kamocat/ErgoDox/ErgoDOX pcb/ErgoDOX_right.kicad_pcb

## KiCad design ErgoDOX pcb/ErgoDOX_right.kicad_pcb (2020-11-01)

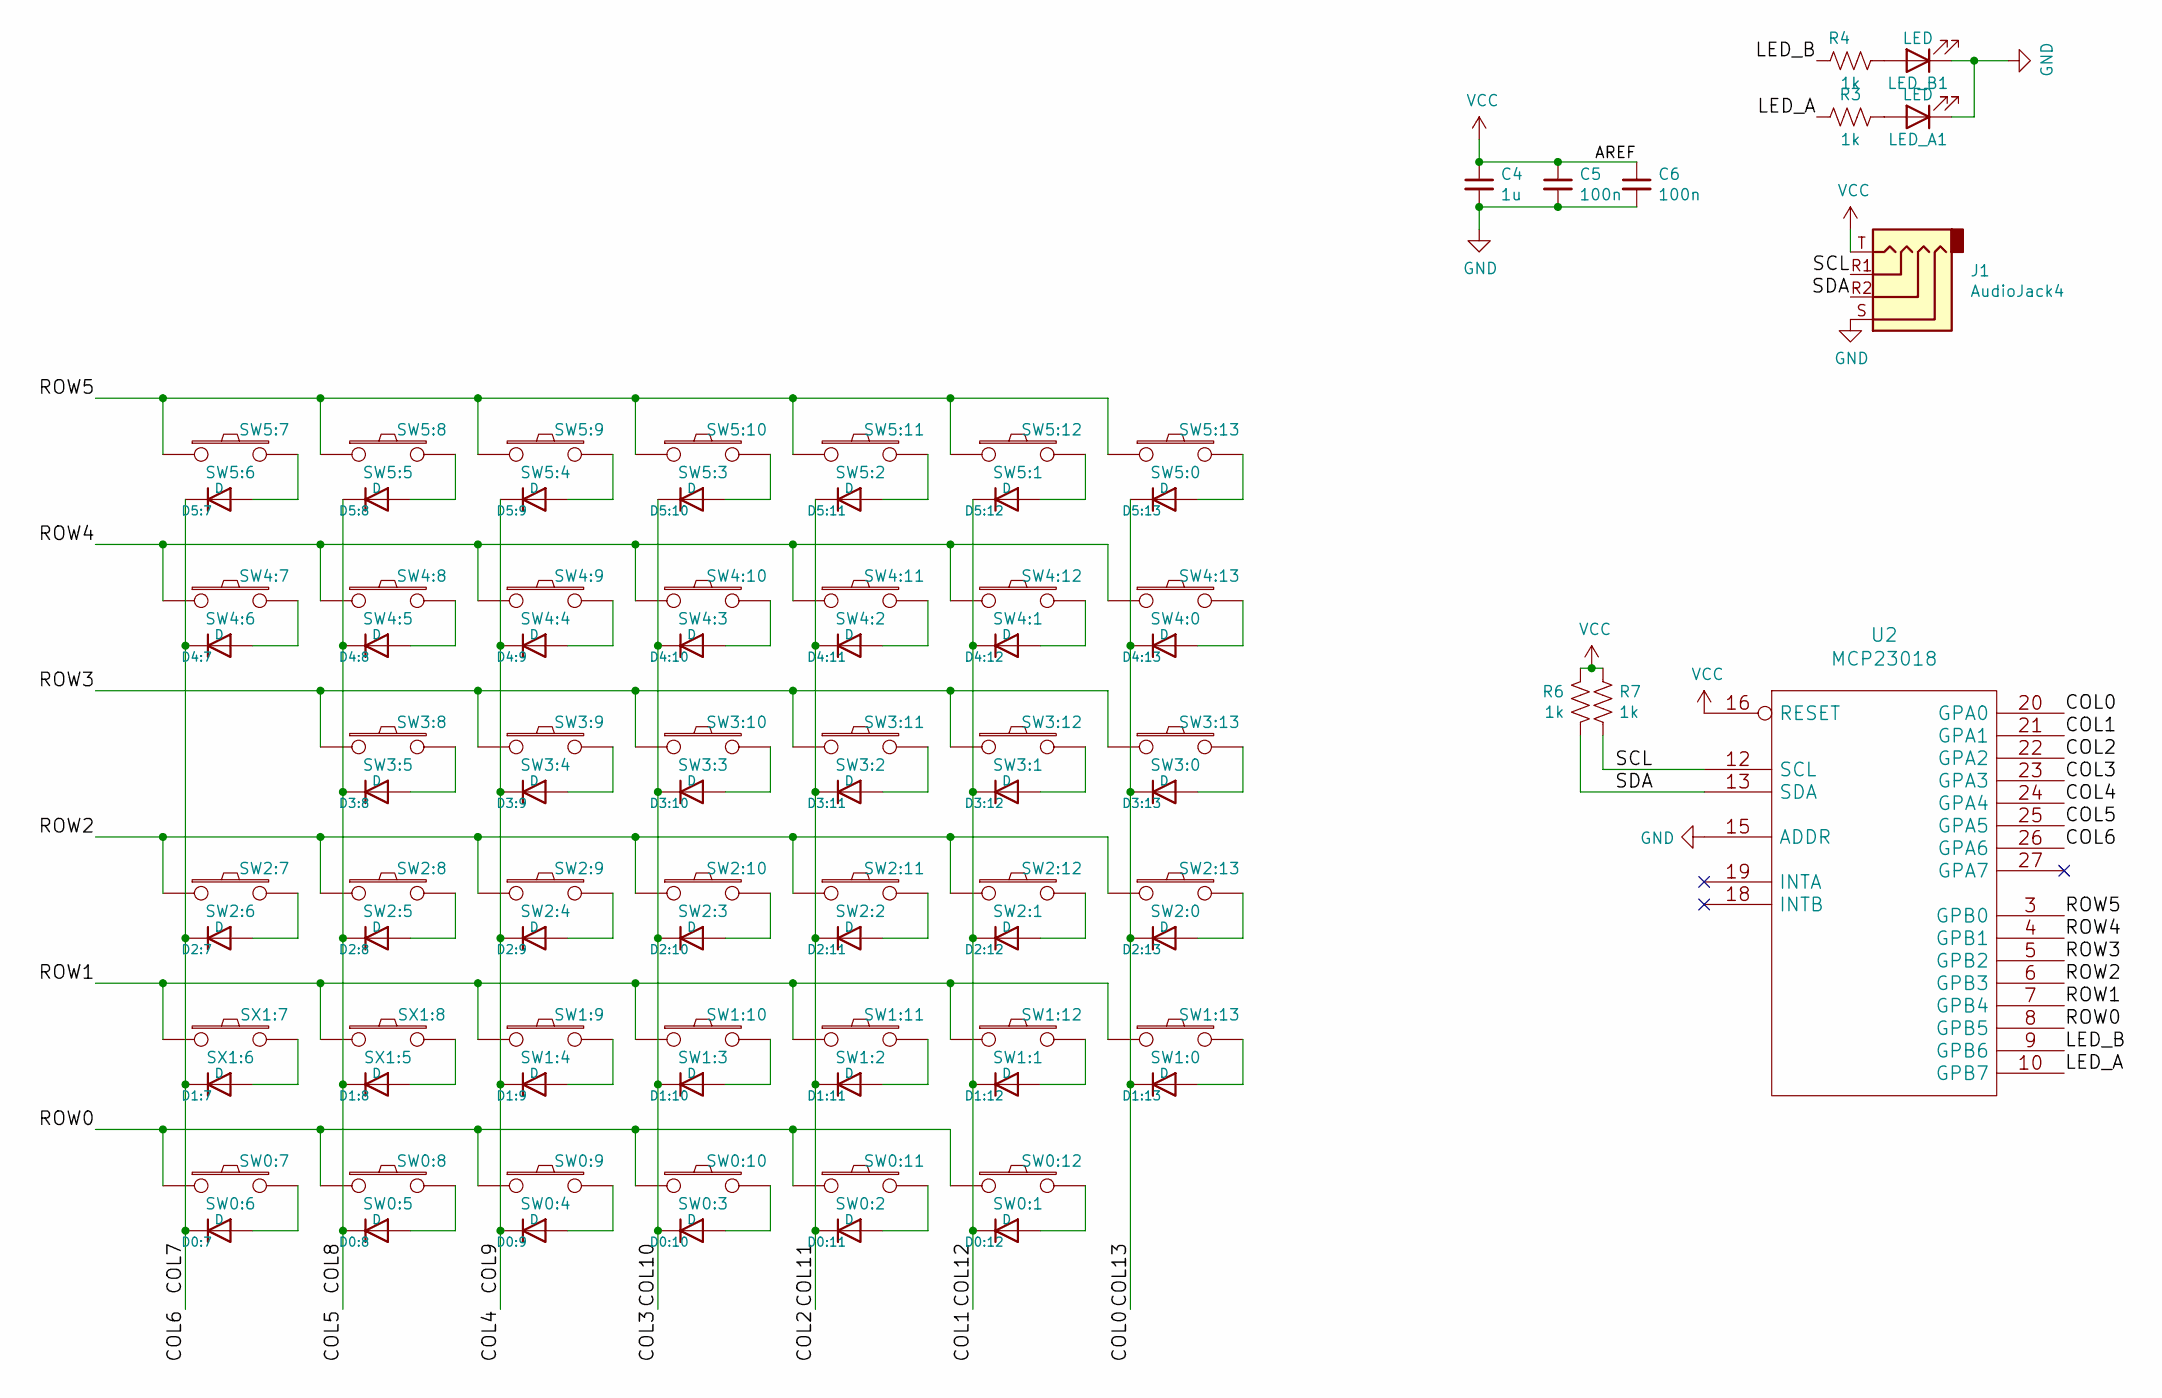
[picture p1: schematic ErgoDOX_right.sch, ErgoDox Right]

Parts:
C4: 1u; C_0603
C5, C6: 100n; C_0603
D0:7, D0:8, D0:9, D0:10, D0:11, D0:12, D1:7, D1:8, D1:9, D1:10, D1:11, D1:12, D1:13, D2:7, D2:8, D2:9, D2:10, D2:11, D2:12, D2:13, D3:8, D3:9, D3:10, D3:11, D3:12, D3:13, D4:7, D4:8, D4:9, D4:10, D4:11, D4:12, D4:13, D5:7, D5:8, D5:9, D5:10, D5:11, D5:12, D5:13: D; D_SOD-123
J1: AudioJack4; 54-00174
LED_A1: LED; LED_0603
LED_B1: LED; LED_0603
R3, R4, R6, R7: 1k; R_0603
SW0:7: SW0:6; MX_TOP
SW0:8: SW0:5; MX_TOP
SW0:9: SW0:4; MX_TOP
SW0:10: SW0:3; MX_TOP
SW0:11: SW0:2; MX_TOP
SW0:12: SW0:1; MX_TOP
SW1:9: SW1:4; MX_TOP
SW1:10: SW1:3; MX_TOP
SW1:11: SW1:2; MX_TOP
SW1:12: SW1:1; MX_TOP
SW1:13: SW1:0; MX_TOP
SW2:7: SW2:6; MX_TOP
SW2:8: SW2:5; MX_TOP
SW2:9: SW2:4; MX_TOP
SW2:10: SW2:3; MX_TOP
SW2:11: SW2:2; MX_TOP
SW2:12: SW2:1; MX_TOP
SW2:13: SW2:0; MX_TOP
SW3:8: SW3:5; MX_TOP
SW3:9: SW3:4; MX_TOP
SW3:10: SW3:3; MX_TOP
SW3:11: SW3:2; MX_TOP
SW3:12: SW3:1; MX_TOP
SW3:13: SW3:0; MX_TOP
SW4:7: SW4:6; MX_TOP
SW4:8: SW4:5; MX_TOP
SW4:9: SW4:4; MX_TOP
SW4:10: SW4:3; MX_TOP
SW4:11: SW4:2; MX_TOP
SW4:12: SW4:1; MX_TOP
SW4:13: SW4:0; MX_TOP
SW5:7: SW5:6; MX_TOP
SW5:8: SW5:5; MX_TOP
SW5:9: SW5:4; MX_TOP
SW5:10: SW5:3; MX_TOP
SW5:11: SW5:2; MX_TOP
SW5:12: SW5:1; MX_TOP
SW5:13: SW5:0; MX_TOP
SX1:7: SX1:6; MX_TOP
SX1:8: SX1:5; MX_TOP
U2: MCP23018; SOIC-28W_7.5x17.9mm_Pitch1.27mm

Connections:
/COL0: D1:13.1 (K), D2:13.1 (K), D3:13.1 (K), D4:13.1 (K), D5:13.1 (K), U2.20 (GPA0)
/COL1: D0:12.1 (K), D1:12.1 (K), D2:12.1 (K), D3:12.1 (K), D4:12.1 (K), D5:12.1 (K), U2.21 (GPA1)
/COL4: D0:9.1 (K), D1:9.1 (K), D2:9.1 (K), D3:9.1 (K), D4:9.1 (K), D5:9.1 (K), U2.24 (GPA4)
/COL5: D0:8.1 (K), D1:8.1 (K), D2:8.1 (K), D3:8.1 (K), D4:8.1 (K), D5:8.1 (K), U2.25 (GPA5)
/COL6: D0:7.1 (K), D1:7.1 (K), D2:7.1 (K), D4:7.1 (K), D5:7.1 (K), U2.26 (GPA6)
/COL10: D0:10.1 (K), D1:10.1 (K), D2:10.1 (K), D3:10.1 (K), D4:10.1 (K), D5:10.1 (K), U2.23 (GPA3)
/COL11: D0:11.1 (K), D1:11.1 (K), D2:11.1 (K), D3:11.1 (K), D4:11.1 (K), D5:11.1 (K), U2.22 (GPA2)
/LED_A: R3.1, U2.10 (GPB7)
/LED_B: R4.1, U2.9 (GPB6)
/ROW0: SW0:7.1, SW0:8.1, SW0:9.1, SW0:10.1, SW0:11.1, SW0:12.1, U2.8 (GPB5)
/ROW1: SW1:9.1, SW1:10.1, SW1:11.1, SW1:12.1, SW1:13.1, SX1:7.1, SX1:8.1, U2.7 (GPB4)
/ROW2: SW2:7.1, SW2:8.1, SW2:9.1, SW2:10.1, SW2:11.1, SW2:12.1, SW2:13.1, U2.6 (GPB3)
/ROW3: SW3:8.1, SW3:9.1, SW3:10.1, SW3:11.1, SW3:12.1, SW3:13.1, U2.5 (GPB2)
/ROW4: SW4:7.1, SW4:8.1, SW4:9.1, SW4:10.1, SW4:11.1, SW4:12.1, SW4:13.1, U2.4 (GPB1)
/ROW5: SW5:7.1, SW5:8.1, SW5:9.1, SW5:10.1, SW5:11.1, SW5:12.1, SW5:13.1, U2.3 (GPB0)
/SCL: J1.R1, R7.2, U2.12 (SCL)
/SDA: J1.R2, R6.1, U2.13 (SDA)
GND: C4.2, C5.2, C6.2, J1.S, LED_A1.1 (K), LED_B1.1 (K), U2.1 (GND), U2.15 (ADDR)
unnamed: D0:7.2 (A), SW0:7.2
unnamed: D0:8.2 (A), SW0:8.2
unnamed: D0:9.2 (A), SW0:9.2
unnamed: D0:10.2 (A), SW0:10.2
unnamed: D0:11.2 (A), SW0:11.2
unnamed: D0:12.2 (A), SW0:12.2
unnamed: D1:7.2 (A), SX1:7.2
unnamed: D1:8.2 (A), SX1:8.2
unnamed: D1:9.2 (A), SW1:9.2
unnamed: D1:10.2 (A), SW1:10.2
unnamed: D1:11.2 (A), SW1:11.2
unnamed: D1:12.2 (A), SW1:12.2
unnamed: D1:13.2 (A), SW1:13.2
unnamed: D2:7.2 (A), SW2:7.2
unnamed: D2:8.2 (A), SW2:8.2
unnamed: D2:9.2 (A), SW2:9.2
unnamed: D2:10.2 (A), SW2:10.2
unnamed: D2:11.2 (A), SW2:11.2
unnamed: D2:12.2 (A), SW2:12.2
unnamed: D2:13.2 (A), SW2:13.2
unnamed: D3:8.2 (A), SW3:8.2
unnamed: D3:9.2 (A), SW3:9.2
unnamed: D3:10.2 (A), SW3:10.2
unnamed: D3:11.2 (A), SW3:11.2
unnamed: D3:12.2 (A), SW3:12.2
unnamed: D3:13.2 (A), SW3:13.2
unnamed: D4:7.2 (A), SW4:7.2
unnamed: D4:8.2 (A), SW4:8.2
unnamed: D4:9.2 (A), SW4:9.2
unnamed: D4:10.2 (A), SW4:10.2
unnamed: D4:11.2 (A), SW4:11.2
unnamed: D4:12.2 (A), SW4:12.2
unnamed: D4:13.2 (A), SW4:13.2
unnamed: D5:7.2 (A), SW5:7.2
unnamed: D5:8.2 (A), SW5:8.2
unnamed: D5:9.2 (A), SW5:9.2
unnamed: D5:10.2 (A), SW5:10.2
unnamed: D5:11.2 (A), SW5:11.2
unnamed: D5:12.2 (A), SW5:12.2
unnamed: D5:13.2 (A), SW5:13.2
unnamed: LED_A1.2 (A), R3.2
unnamed: LED_B1.2 (A), R4.2
VCC: C4.1, C5.1, C6.1, J1.T, R6.2, R7.1, U2.11 (VCC), U2.16 (RESET)

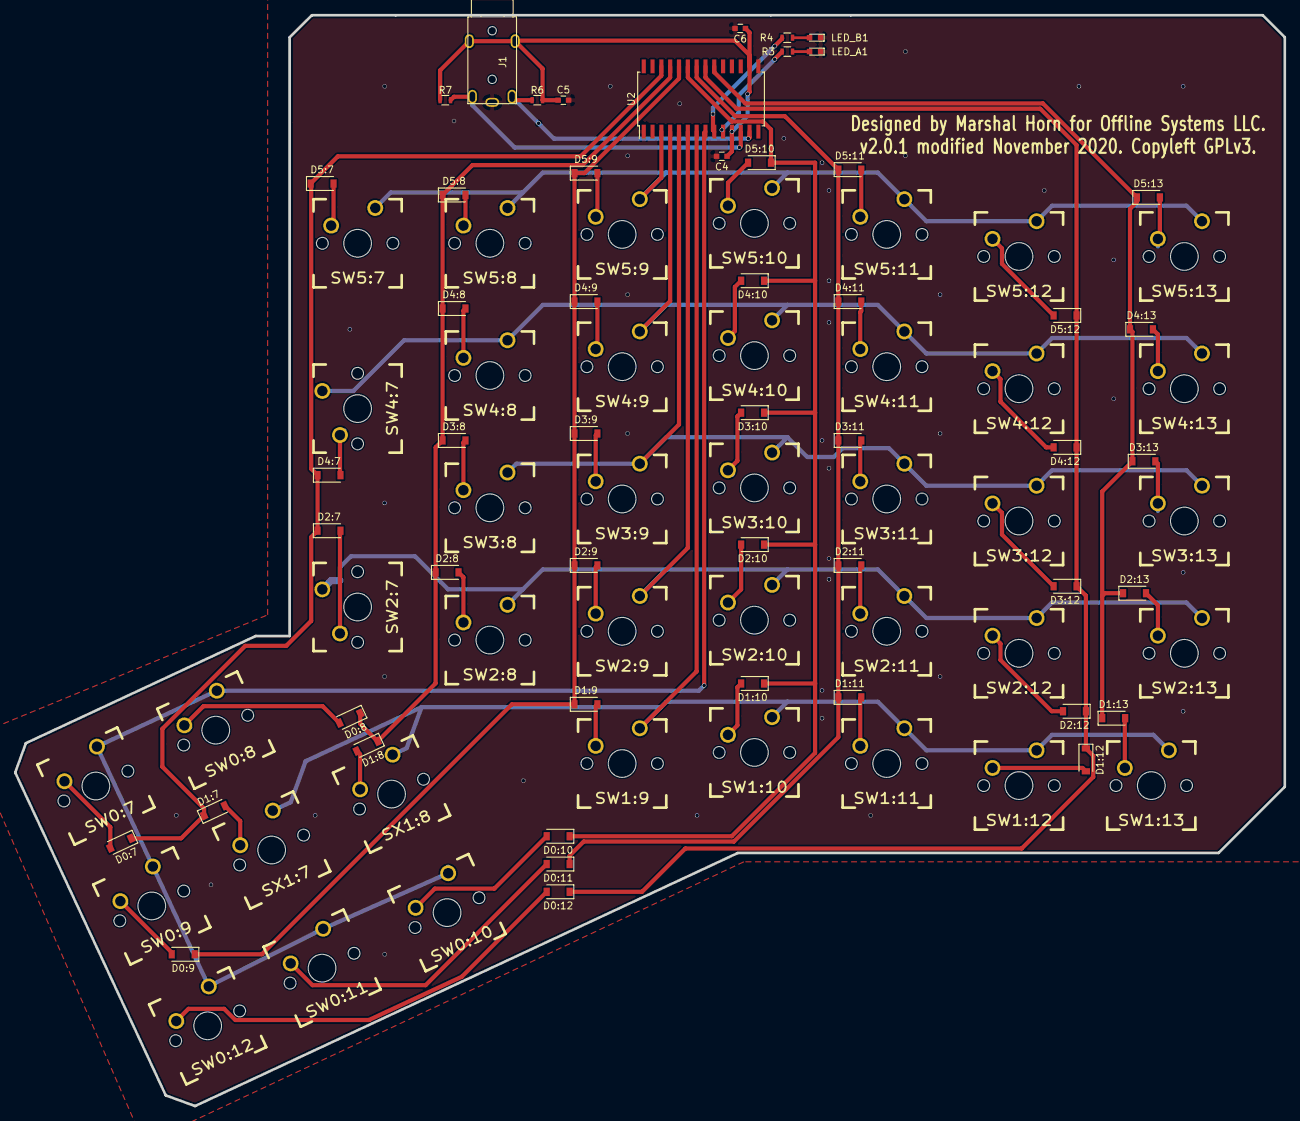
[picture p2: board ErgoDOX_right.kicad_pcb from above]

Board: 2 copper layers, 182.8 x 157.1 mm, 91 parts (0 on the bottom side), 61 nets.
