kamocat/ErgoDox/(threads)

Thread 1 (2020-11-24):

Manufacturing issues

kamocat, 2020-11-24:
- Mounting plate extends too far up. Also expensive: JLCPCB charged $30 for 5
- Long keycaps don't fit
- USB connectors should be sideways so they can be tested without breaking them apart. Alignment on microUSB is difficult due to wrong part (design part was backordered).
- Prettify the USB breakout. Chamfered edges? Be careful that it doesn't overlap the LEDs
- Left/right is flipped from Ergodox_EZ firmware.

kamocat, 2020-11-24:
Also needed: mounting holes
