kamocat/ErgoDox/(commit log)

2020-09-17 Replaced teensy with atmega
    Imported project into new version of KiCad
    Initial routing of traces is done
    Switch footprints need some investigation - overlap is throwing design rule errors
    [ErgoDOX.kicad_pcb, ErgoDOX.sch]
2020-10-03 migrated to newer KiCAD
    [ErgoDOX.kicad_pcb, ErgoDOX.sch]
2020-10-05 Changed footprints for easier manufacturability
    * Diodes are now surface-mount. Don't buy the switches with built-in diodes.
    * Changed processor from at90usb1286 to atmega32u4 (due to availability and cost)
    * Renamed footprint library
    [ErgoDOX.sch]
2020-10-08 Placed diodes, started routing
    [ErgoDOX.kicad_pcb, ErgoDOX.sch]
2020-10-08 Split boards into LH and RH
    [ErgoDOX.brd, ErgoDOX_left.kicad_pcb, ErgoDOX_left.sch, ErgoDOX_right.kicad_pcb, ErgoDOX_right.sch]
2020-10-09 finished LH routing
    [ErgoDOX_left.kicad_pcb, ErgoDOX_left.sch]
2020-10-09 USB breakout draft
    [ErgoDOX_left.kicad_pcb, ErgoDOX_left.sch]
2020-10-09 Routed RH board
    [ErgoDOX_right.kicad_pcb, ErgoDOX_right.sch]
2020-10-09 Updated USB footprints
    [ErgoDOX_left.kicad_pcb, ErgoDOX_left.sch]
2020-10-09 Removed old gerber files
    [ErgoDOX-B.Mask.gbs, ErgoDOX-B.Paste.gbp, ErgoDOX-B.SilkS.gbo, ErgoDOX-Back.gbl, ErgoDOX-Cmts.User.gbr, ErgoDOX-Dwgs.User.gbr, ErgoDOX-Eco1.User.gbr, ErgoDOX-Eco2.User.gbr]
2020-10-12 Added revision, generated gerbers
    [ErgoDOX_left-B_CrtYd.gbr, ErgoDOX_left-B_Mask.gbs, ErgoDOX_left-B_Paste.gbp, ErgoDOX_left-B_SilkS.gbo, ErgoDOX_left-Back.gbl, ErgoDOX_left-Cmts_User.gbr, ErgoDOX_left-Dwgs_User.gbr, ErgoDOX_left-Eco1_User.gbr]
2020-10-12 Corrected revision number
    [ErgoDOX_left.sch]
2020-10-16 Removed soldermask clearance
    Re-generated gerbers for left PCB
    Added BOM and placement file for left PCB
    [ErgoDOX_left-B_CrtYd.gbr, ErgoDOX_left-B_Mask.gbs, ErgoDOX_left-B_Paste.gbp, ErgoDOX_left-B_SilkS.gbo, ErgoDOX_left-Back.gbl, ErgoDOX_left-Cmts_User.gbr, ErgoDOX_left-Dwgs_User.gbr, ErgoDOX_left-Eco1_User.gbr]
2020-10-27 Added BOM and CPL files for JLC assembly
    [ErgoDOX_right.csv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]
2020-11-01 Switched MCP23018 to SOIC package
    [ErgoDOX_right-B_CrtYd.gbr, ErgoDOX_right-B_Mask.gbs, ErgoDOX_right-B_Paste.gbp, ErgoDOX_right-B_SilkS.gbo, ErgoDOX_right-Back.gbl, ErgoDOX_right-Cmts_User.gbr, ErgoDOX_right-Dwgs_User.gbr, ErgoDOX_right-Eco1_User.gbr]
2020-11-01 Fixed position file headers for JLC
    [ErgoDOX_right-top-pos.csv]
