kamocat/ErgoDox/(notices)

Notices in the files:
ErgoDOX pcb/ErgoDOX_right.kicad_pcb:
v2.0.1 modified November 2020. Copyleft GPLv3.
ErgoDOX pcb/ErgoDOX_left.kicad_pcb:
v2.0.0 modified October 2020. Copyleft GPLv3.
parts and their libraries:
Copyright 2016 Accelerated Designs. All rights reserved.
